johan-954/Projet_1DA/Commande/DigiKey/2026-05-20T041745.xlsx

DigiKey - Panier
Index | Quantité | Référence | Référence fabricant | Description | Référence client | Disponible | Articles différés | Prix unitaire | Prix calculé EUR
1 | 2 | 5272-AMS1117-5.0CT-ND | AMS1117-5.0 | IC REG LINEAR 5V 1A SOT-223-3L |  | 2 | 0 | 0.25 | 0.50
2 | 1 | 1778-COM3700-ND | COM3700 | MINI SUBMERSIBLE WATER PUMP |  | 1 | 0 | 3.14 | 3.14
