johan-954/Projet_1DA/KiCad/Utilities/1294/1294.step

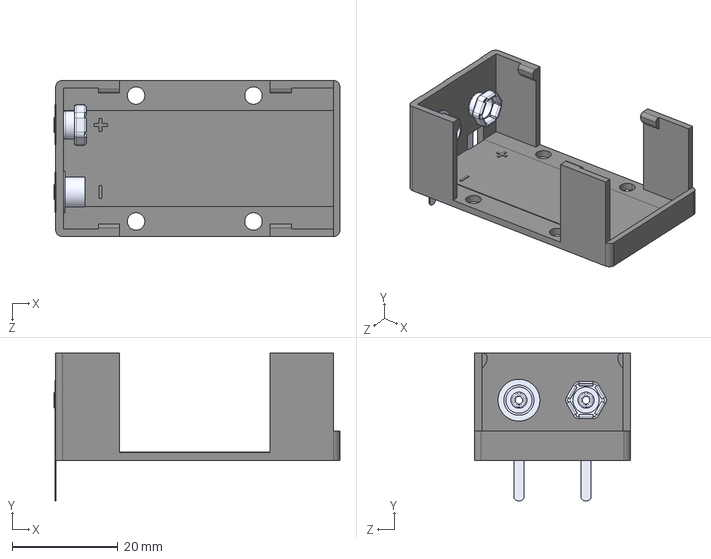
[picture p7: CAD file, 2026-05-06]
KiCad/Utilities/1294/1294.step
54.2 x 27.9 x 29.6 mm
