johan-954/Projet_1DA/KiCad/Utilities/BC547C/BC547C.step

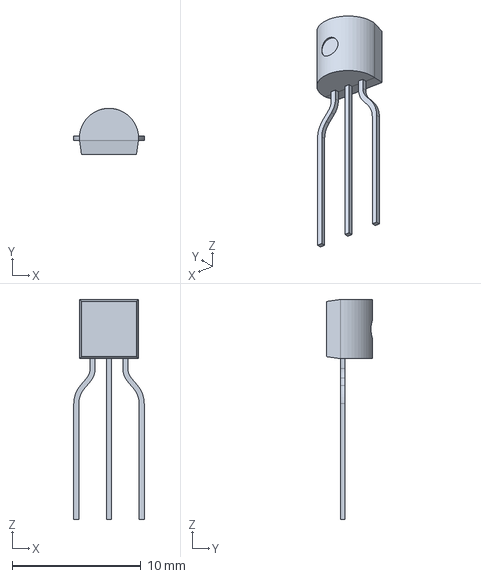
[picture p8: CAD file, 2026-05-04]
KiCad/Utilities/BC547C/BC547C.step
5.48 x 3.60 x 17.1 mm
