johan-954/Projet_1DA/KiCad/Utilities/ESP32-C3_SUPERMINI_TH/ESP32-C3_SUPERMINI_TH.step

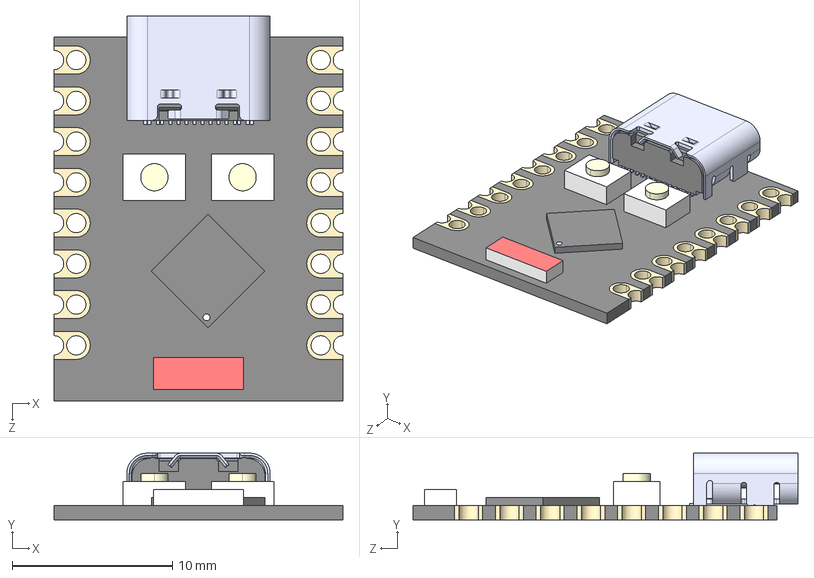
[picture p9: CAD file, 2026-05-04]
KiCad/Utilities/ESP32-C3_SUPERMINI_TH/ESP32-C3_SUPERMINI_TH.step
18.0 x 4.16 x 24.0 mm
Board c3mini
USB C
components (other)^ESP32-C3 SuperMini
