johan-954/Projet_1DA/KiCad/Utilities/MCP6022-I_ST/MCP6022-I_ST.step

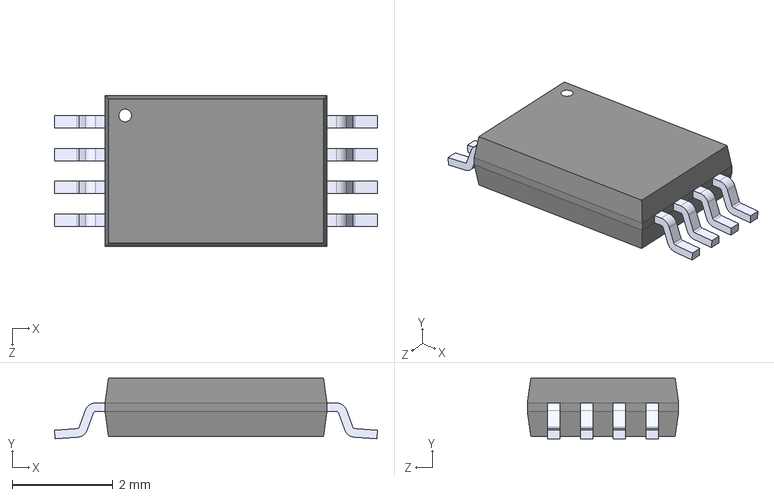
[picture p10: CAD file, 2026-05-04]
KiCad/Utilities/MCP6022-I_ST/MCP6022-I_ST.step
6.40 x 1.20 x 3.00 mm
