johan-954/Projet_1DA/IUT/Dossier de fabrication de la carte luminosité LOUVET - KARAMA.docx

Dossier de fabrication DE LA CARTE Capteur de luminositE

SAE s2

TD3/TP6

Antonin LOUVET & Mohammed-Amine KARAMA

VI. Liste des composants avec leurs références et une estimation du prix19

VIII. Conclusion20

I. Sommaire des figures :

Figure 1 : Diagramme de la bête à corne4

Figure 2 : Schéma électronique de la carte capteur de luminosité5

Figure 3 : Schéma Proteus de la fonction FS1, connecteur 9 broches mâle6

Figure 4 : Schéma de la fonction FS2, détection de la carte7

Figure 5 : Schéma simplifié D3 de la fonction FS2, détection de la carte8

Figure 6 : Schéma simplifié D2 de la fonction FS2, détection de la carte et schéma équivalent 9

Figure 7 : Schéma Proteus de la fonction FS3, polarisation de la diode10

Figure 8 : Graphique du courant Ip et de la tension V0 en fonction de la luminosité Ev11

Figure 9 : Schéma Proteus de la fonction FS4, montage suiveur12

Figure 10 : Schéma Proteus de la fonction FS5, filtrage13

Figure 11 : Schéma Proteus simplifié de la fonction FS5, filtrage13

Figure 12 : Vue du dessous du circuit (typon)16

Figure 13 : Vue 3D (recto) du circuit (qui fera office de plan de montage)18

Figure 14 : Schéma de principe de l’utilisation de la carte capteur de luminosité20

II. Introduction :

Ce projet de SAE consiste à commercialiser une station de mesure “low-cost”.

On fabrique 3 cartes qui doivent mesurer :

- la température ambiante, en degré Celsius ou Fahrenheit ;
- la luminosité ambiante, en Lux ;
- la distance qui sépare le véhicule d’un objet, en mètre.

Ce produit est destiné aux conducteurs de voitures qui auront besoin :

- de connaître la température ambiante à l’intérieur et à l’extérieur du véhicule ;

- de mesurer la luminosité ambiante à l’intérieur et à l’extérieur du véhicule et en fonction du résultat, changer l’apparence du GPS ;

- d’évaluer la distance qui sépare le véhicule de l’environnement lors d’une manœuvre.

Expression du besoin

Figure 1 : Diagramme de la bête à corne

Les conducteurs

Station de Mesure

Mesurer et afficher des grandeurs physiques liées à un véhicule : température, luminosité et distance

Environnement intérieur/extérieur et proche du véhicule

Dans cette deuxième partie, il va s’agir d’étudier le capteur de luminosité.

Pour obtenir la valeur de la luminosité ambiante, il faut utiliser une photodiode dont la tension aux bornes varie en fonction du courant et de la luminosité.

Pour la réalisation de cette deuxième carte, le schéma électronique de la carte capteur de luminosité présentera plusieurs fonctions :

- FS1 : Connecteur 9 broches avec les différentes entrées et sorties ;

- FS2 : Détection de la carte ;

- FS3 : Polarisation de la photodiode ;

- FS4 : Montage suiveur ;

- FS5 : Filtrage.

Figure 2 : Schéma électronique de la carte capteur de luminosité


Pour l’étude du schéma électronique de la carte capteur de luminosité, on cherche à déterminer les composants dont on ne connaît pas encore les valeurs ainsi que l’utilité de chacune des fonctions.

Il faut commencer par étudier la fonction FS1 :

Pour que la carte puisse être reliée à la carte micro (station de mesure), il faut qu’elle possède un connecteur 9 broches ; ce connecteur permet de faire passer des tensions et des courants d’entrée et de sortie entre la carte et la station de mesure.

Figure 3 : Schéma Proteus de la fonction FS1, connecteur 9 broches mâle

Puis il faut étudier la fonction FS2 :

- Pour la détection d’un tel capteur par le microcontrôleur, on utilise deux entrées numériques P0 et P1 pour déterminer la résistance R1 afin que VD3 > 3V.

Figure 4 : Schéma de la fonction FS2, détection de la carte

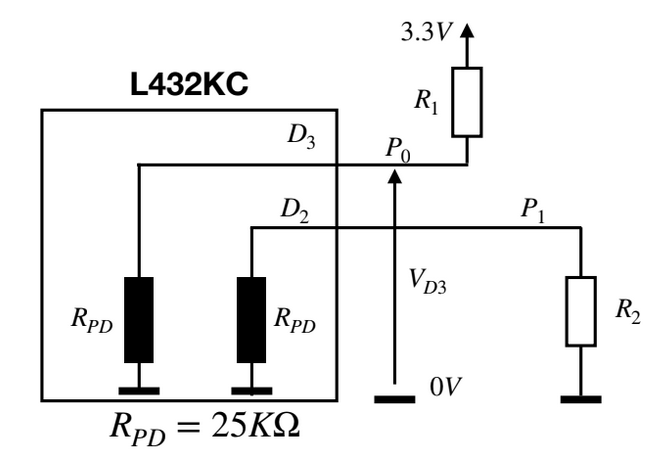
[picture p11: figure]

On simplifie le schéma D3 de la fonction FS2, détection de la carte.

Figure 5 : Schéma simplifié D3 de la fonction FS2, détection de la carte

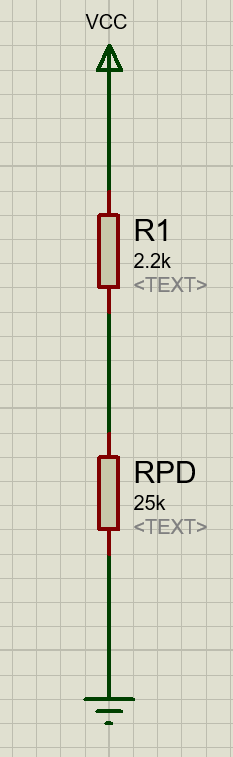
[picture p12: figure]

Vd3 ⩾ 3 V

Ve = 3,3 V

On étudie le schéma simplifié de la fonction FS2, détection de la carte :

D’après le théorème du pont diviseur, on a VD3 = (R_(PD))/(R_(PD) +R_1) *V_e

On cherche VD3 = (R_(PD))/(R_(PD) +R_1) *V_e ≥ V_(seuil) avec V_(seuil) = 3 V

Donc R_(PD) *V_e ≥ V_(seuil) * ( R_(PD) +R_1 ) ⇔ (R_(PD) * V_e)/(V_(seuil)) ≥ ( R_(PD) +R_1 ) ⇔ (R_(PD) * V_e)/(V_(seuil)) - R_(PD) ≥ R_1

Application numérique : R_1 ≤ (25000 * 3,3)/3 – 25000 donc R_1 ≤ 2500 Ω

Comme il n’y a pas de résistance de 2,5 kΩ, on utilise une résistance normalisée de 2,2 kΩ pour R_1 , celle-ci correspond à la valeur la plus proche de celle calculée.

- On cherche également à déterminer la résistance R2 afin que la résistance équivalente sur D2 soit de 20KΩ.

On simplifie la deuxième partie D2 du schéma de la fonction FS2, détection de la carte, afin de déterminer la valeur de la résistance R2.

Figure 6 : Schéma simplifié D2 de la fonction FS2, détection de la carte et schéma équivalent

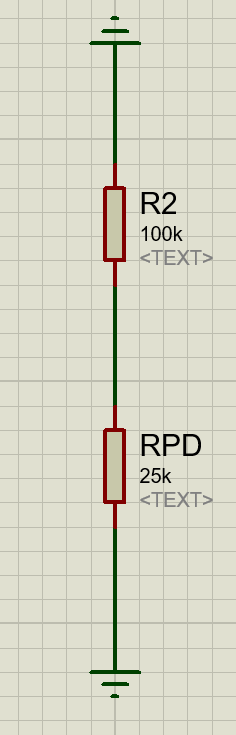
[picture p13: figure]
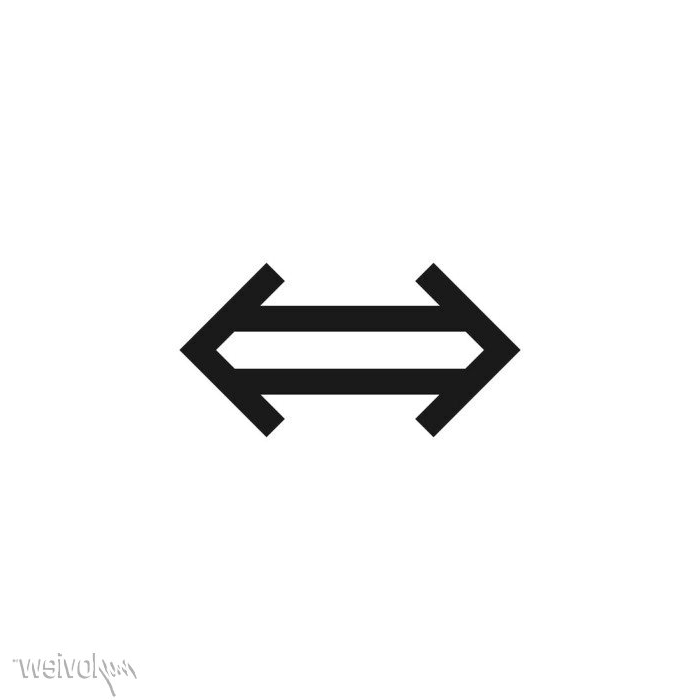
[picture p14: figure]
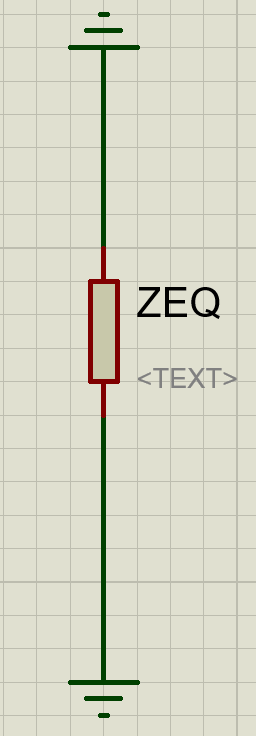
[picture p15: figure]

On étudie le schéma simplifié D2 de la fonction FS2, détection de la carte et son schéma équivalent :

Zeq = (R_2 * R_(PD))/(R_2 + R_(PD)) comme Zeq = 20000 Ω ⇔ (R_2 * R_(PD))/(R_2 + R_(PD)) = 20000 ⇔ R_2 * R_(PD) = 20000 * ( R_2 + R_(PD) )

⇔ R_2 * R_(PD) = 20000 * R_2 + 20000*R_(PD) ⇔ R_2 = 20000 * (R_2)/(R_(PD)) + 20000

⇔ R_2 = R_2 * 20000/25000 + 20000 ⇔ R_2 = R_2 * 20000/25000 + 20000 ⇔ R_2 = R_2 * 0,8 + 20000

⇔ R_2 - R_2 * 0,8 = 20000 ⇔ R_2 * 0,2 = 20000 ⇔ R_2 = 20000/(0,2) ⇔ R_2 = 100 kΩ

On prend donc une résistance R2 de 100 kΩ.

Puis il faut étudier la fonction FS3 :

Celle-ci permet de polariser la diode et de choisir le point de fonctionnement.

Figure 7 : Schéma Proteus de la fonction FS3, polarisation de la diode

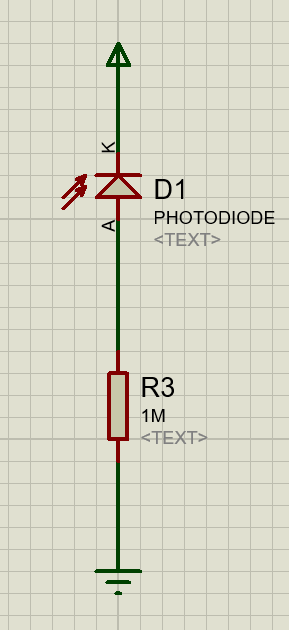
[picture p16: figure]

Ve = 3,3 V

Ip = 1 µA

Vm

On cherche à déterminer le courant inverse dans la photodiode pour un éclairement Ev = 100 lux ; on étudie donc le graphique ci-dessous, indiquant le courant Ip ( en µA ) et la tension V0 ( en mV ) en fonction de la luminosité Ev ( en lux ).

Figure 8 : Graphique du courant Ip et de la tension V0 en fonction de la luminosité Ev

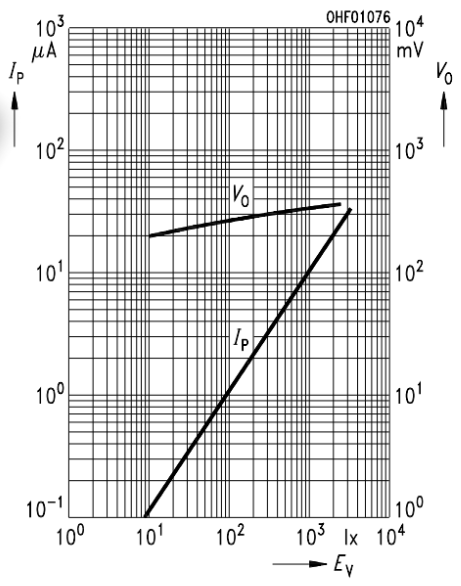
[picture p17: figure]

D’après le graphique du courant Ip et de la tension V0 en fonction de la luminosité Ev, pour EV = 100 lux on a Ip = 1 µA.

On cherche ensuite à estimer la tension aux bornes de R3 = 1 MΩ.

On étudie le schéma Proteus de la fonction FS3, polarisation de la diode.

D’après la Loi d’Ohm : Vm = R3 * IP

Donc Vm = 1*10⁶ *1*10⁻⁶ ⇒ Vm = 1 V

On a donc une tension Vm de 1 V.

Ensuite, on étudie la fonction FS4.

Figure 9 : Schéma Proteus de la fonction FS4, montage suiveur

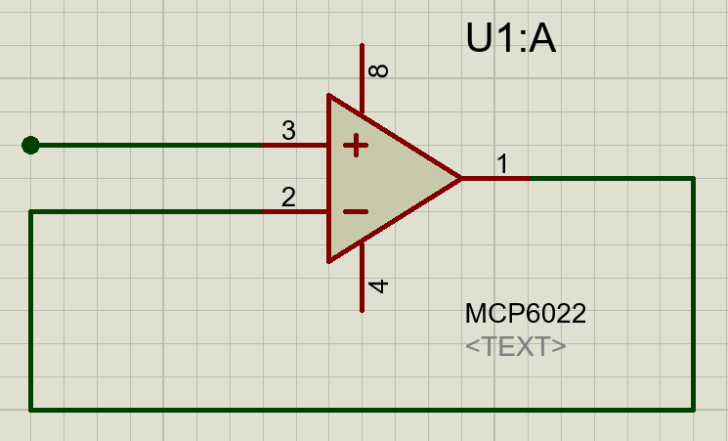
[picture p18: figure]

Vm

V

La fonction FS4, du montage suiveur, permet de :

- copier la tension d’entrée V sur la tension de sortie Vm ;

- isoler les différentes parties du circuit.

Pour finir, on étudie la fonction FS5 :

La fonction FS5 permet de filtrer les parasites lorsque la fréquence est supérieure à 10 Hz.

Des parasites apparaissent lorsque nous branchons ou débranchons la carte.

Figure 10 : Schéma Proteus de la fonction FS5, filtrage

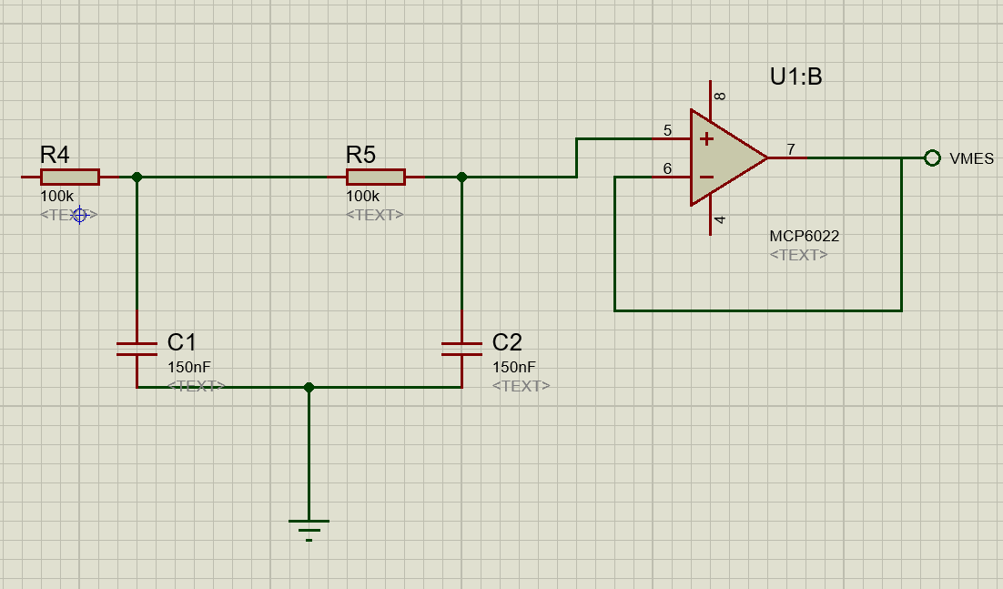
[picture p19: figure]

Vmes

Vm

On cherche à déterminer les valeurs de R4, R5, C1 et C2.

On simplifie alors le schéma Proteus de la fonction FS5, filtrage, en utilisant le théorème de Thévenin :

Figure 11 : Schéma Proteus simplifié de la fonction FS5, filtrage

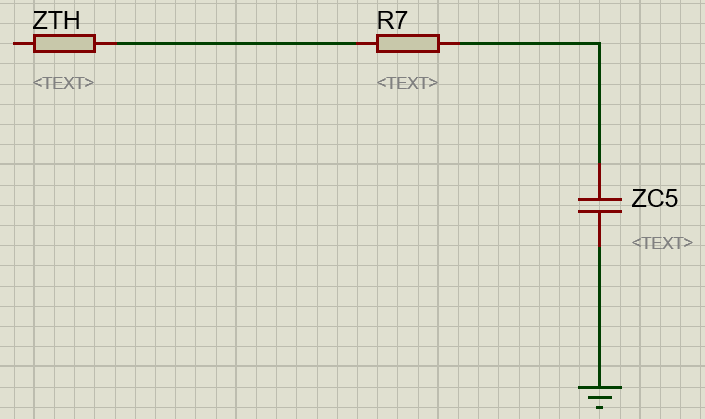
[picture p20: figure]

Vmes

eTH

On calcule la fonction de transfert du filtre du second ordre (v_(mes))/(v_m) (jw):

D’après le schéma Proteus simplifié de la fonction FS5, filtrage, on a :

Zth = (R_4 * 1/(JC1W))/(R_4 + 1/(JC1W)) ⇔ Zth = (R_4)/(JR_4 C1W + 1)

Et Eth = (1/(JC1W))/(R_4 + 1/(JC1W)) * Vm ⇔ Eth = 1/(JR_4 C1W + 1) * Vm

D’après le théorème du pont diviseur :

Vmes = (1/(JC2W))/(R_5 + 1/(JC2W) + Zth) * Eth ⇔ Vmes = 1/(1 + JR_5 C2W + (JR_4 C2W)/(1+JR_4 C1W)) * Eth

⇔ Vmes = 1/(1 + JR_5 C2W + (JR_4 C2W)/(1+JR_4 C1W)) * 1/(JR_4 C1W + 1) * Vm

⇔ Vmes = 1/(JR_4 C1W + 1 + JR_5 C2W + ( JR_5 C2W ) * ( JR_4 C1W ) + JR_4 C2W) * Vm

⇔ (Vmes)/(Vm) = 1/(1 + JW ( R_4 C1 + R_5 C2 + R_4 C2 )+ (JW)^2 * ( R_5 R_4 C2C1 ))

On sait que (Vmes)/(Vm) = 1/(1 + J W/(W0) 2m + (JW/(W0))^2) (forme canonique du second ordre)

Par identification :

1/(W_0^2) = R_5 R_4 C2C1 ⇔ W_0^2 = 1/(R_5 R_4 C2C1) ⇔ W_0^() = 1/(√(R_5 R_4 C2C1))

et (2m)/(W_0^()) = ( R_4 C1 + R_5 C2 + R_4 C2 ) ⇔ 2m = W_0^() ( R_4 C1 + R_5 C2 + R_4 C2 )

⇔ m = 1/2 (( R_4 C1 + R_5 C2 + R_4 C2 ))/(√(R_5 R_4 C2C1))

Si C1 = C2 = C et R4 = R5 = R

Alors (Vmes)/(Vm) = 1/(1 + 3JRCW + (JRCW)^2)

Par identification :

W0 = 1/(RC) or W0 = 2π*f0 donc 1/(RC) = 2π*f0 ⇔ RC = 1/(2π*fo)

On cherche à déterminer R4, R5, C1 et C2 pour obtenir une fréquence propre f0 = 10 Hz :

Sachant que RC = 1/(2π*fo) ⇔ RC = 1/(2π*10) ⇔ RC = 15,9 * 10⁻³

On prend R = 100 kΩ

Donc C = (15,9 * 10^(-3))/(100 * 10^3) ⇔ C = 1,59 * 10⁻⁷ F = 159 nF

Donc R4 = R5 = 100 kΩ et C1 = C2 = 159 nF

Comme il n’y a pas de condensateur de 159 nF, on utilise deux condensateurs normalisés 150 nF pour C1 et C2, ce qui correspond à la valeur la plus proche de celle calculée.

Figure 12 : Vue de dessous du circuit (typon)

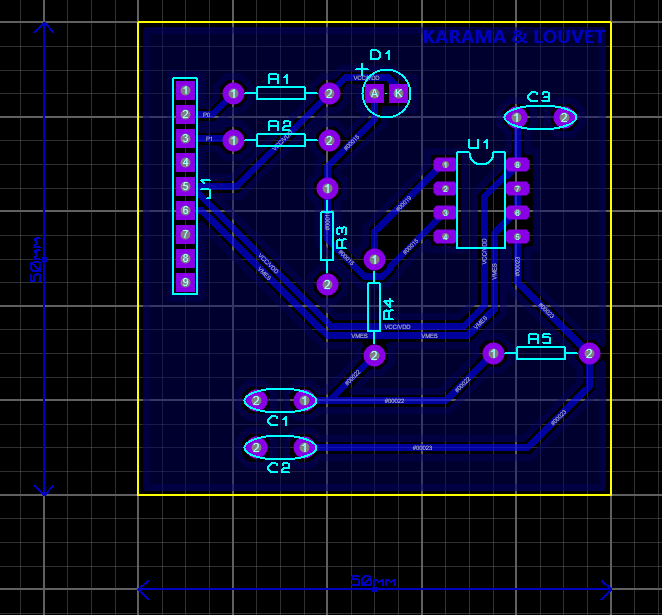
[picture p21: figure]

Pour réaliser le dossier typon, on doit respecter le cahier des charges de la carte luminosité, à savoir :

- un tel capteur sera alimenté en mono tension [0 ; 3.3V] ;
- après une calibration, le capteur fournira en sortie une tension image de la luminosité ambiante ;
- le capteur sera capable de mesurer une luminosité de 0 à 4000 lux ;
- la liaison, entre le capteur et la carte microcontrôleur, sera réalisée via un connecteur 9 broches mâle ;
- pour mesurer la luminosité ambiante, on utilise une photodiode ; en effet il apparait un courant inverse Ip, dont l’intensité est fonction de l’éclairement reçu.

Figures 13 : Vue 3D (recto) du circuit (qui fera office de plan de montage)

VI. Liste des composants avec leurs références et une estimation du prix :

Composants | Valeurs | Références radiospare | Prix
R1 | 2,2kΩ | CFR1-4W-2K2 | 0.17€/Pcs
R2 | 100kΩ | 707-7824 | 0,123 €/Pcs
R3 | 1MΩ | 707-7903 | 0,164 €/Pcs
R4 | 100kΩ | 707-7824 | 0,123 €/Pcs
R5 | 100kΩ | 707-7824 | 0,123 €/Pcs
C1 | 150nF | B32671P6154K000 | 0,64 €/Pcs
C2 | 150nF | B32671P6154K000 | 0,64 €/Pcs
C3 | 470nF | B32672Z4474K000 | 0,53 €/Pcs
D1 | | 1N914 | 0,093 €/Pcs
AOP | | MCP6022 | 1,73 €/Pcs
Connecteur 9 broches | 40 broches | 9-146282-0 | 3,54€/Pcs

Lorsque l’on additionne tous les composants, on obtient :

0,17 + 0,123 + 0,164 + 0,123 + 0,123 + 0,64 + 0,64 + 0,53 + 0,093 + 1,73+ 3,54 = 7,876

Donc le coût de la carte sera de 7,876 €.

VII. Notice d’utilisation :

Cette carte de mesure de la luminosité ambiante sera branchée sur une carte MICRO à l’aide du connecteur 9-broches.

La carte MICRO fonctionne avec un microcontrôleur STM32 Nucleo L432KC et sera reliée à un PC par voie filaire qui possède l’IHM.

Ainsi on obtiendra le Schéma de principe de l’utilisation de la carte capteur de luminosité :

Figure 14 : Schéma de principe de l’utilisation de la carte capteur de luminosité :

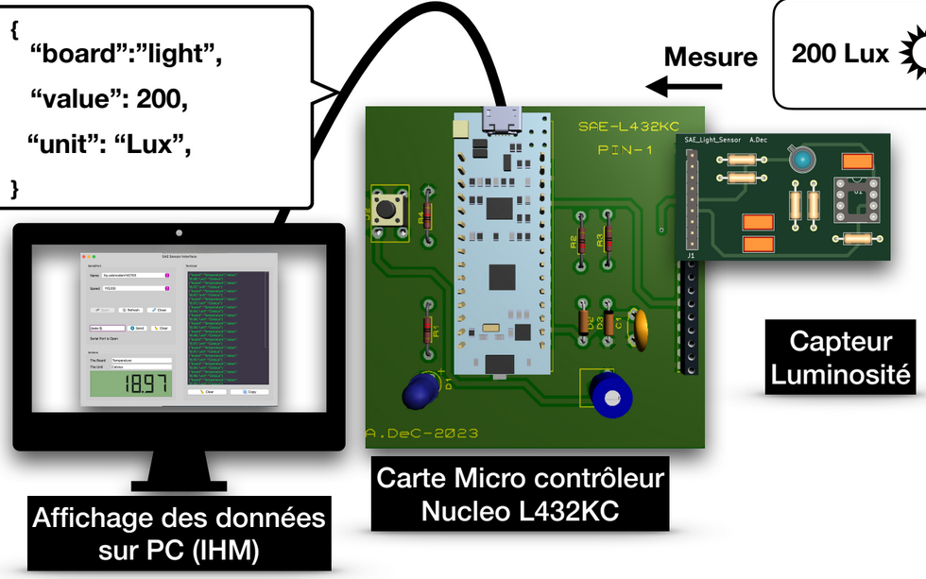
[picture p22: figure]

La carte de mesure est composée d’un capteur à base de photodiode, alimenté en mono tension [0 ; 3.3V]. Après calibration, ce capteur fournira en sortie une tension image de la luminosité ambiante en lux. Cette tension sera envoyée grâce à la carte MICRO vers le PC (IHM) qui affichera donc la luminosité ambiante.

VIII. Conclusion :

Pour conclure, on a choisi les composants qui correspondent aux calculs théoriques. Ceux qui ne correspondent pas aux valeurs théoriques trouvées sont ceux qui sont indisponibles. Par exemple, en l’absence de condensateur de 159 nF, on prend un condensateur de 150 nF. Cependant, le fait de changer la valeur de certains composants n’a pas d’impact sur le bon fonctionnement de la carte.

Il reste donc à réaliser la soudure de la carte, puis procéder à des tests de vérification de son bon fonctionnement et terminer par la programmation.

Dossier de fabrication BUT 1 – SAE S2
