johan-954/Projet_1DA/LTspice/Temperature/Temperature.asc

C1: cap; 100n
C2: cap; 100n
D1: diode
Q1: npn
Q2: npn
R1: res; 33k
R2: res; 10k
R3: res; 10k
R4: res; 10k
R5: res; 10k
R6: res; 10k
R7: res; 2.2k
R8: res; 5.1k
R9: res; 10k
U1: UniversalOpAmp2
U2: UniversalOpAmp2
V1: voltage; 2.5V
V2: voltage; 3.3V
Named nets: 0, +3.3V, +VCom
.tran 0 100m 0 0.01m
.step temp 0 100 25
