johan-954/Projet_1DA/LTspice/Luminosite/Luminosite_-Vdd_Vdd.asc

C1: cap; 100n
C2: cap; 220n
C3: cap; 10p
I1: current; SINE(0 50u 100)
R1: res; 10k
R2: res; 10k
R3: res; 100k
R4: res; 68k
R5: res; 10k
R6: res; 10k
U3: UniversalOpAmp2
U4: UniversalOpAmp2
V1: signal; AC 1 0
V2: voltage; -3.3V
V3: voltage; +3.3V
Named nets: 0, +3.3V, -3.3V
.ac dec 500 1 10k
Sallen Key
.tran 0 100m 0 0.1m
Transformation A/V
Pas necessaire, a voir quand TP
