johan-954/Projet_1DA/KiCad/Luminosite/Luminosite.kicad_pcb

## KiCad design KiCad/Luminosite/Luminosite.kicad_pcb (2026-05-20)

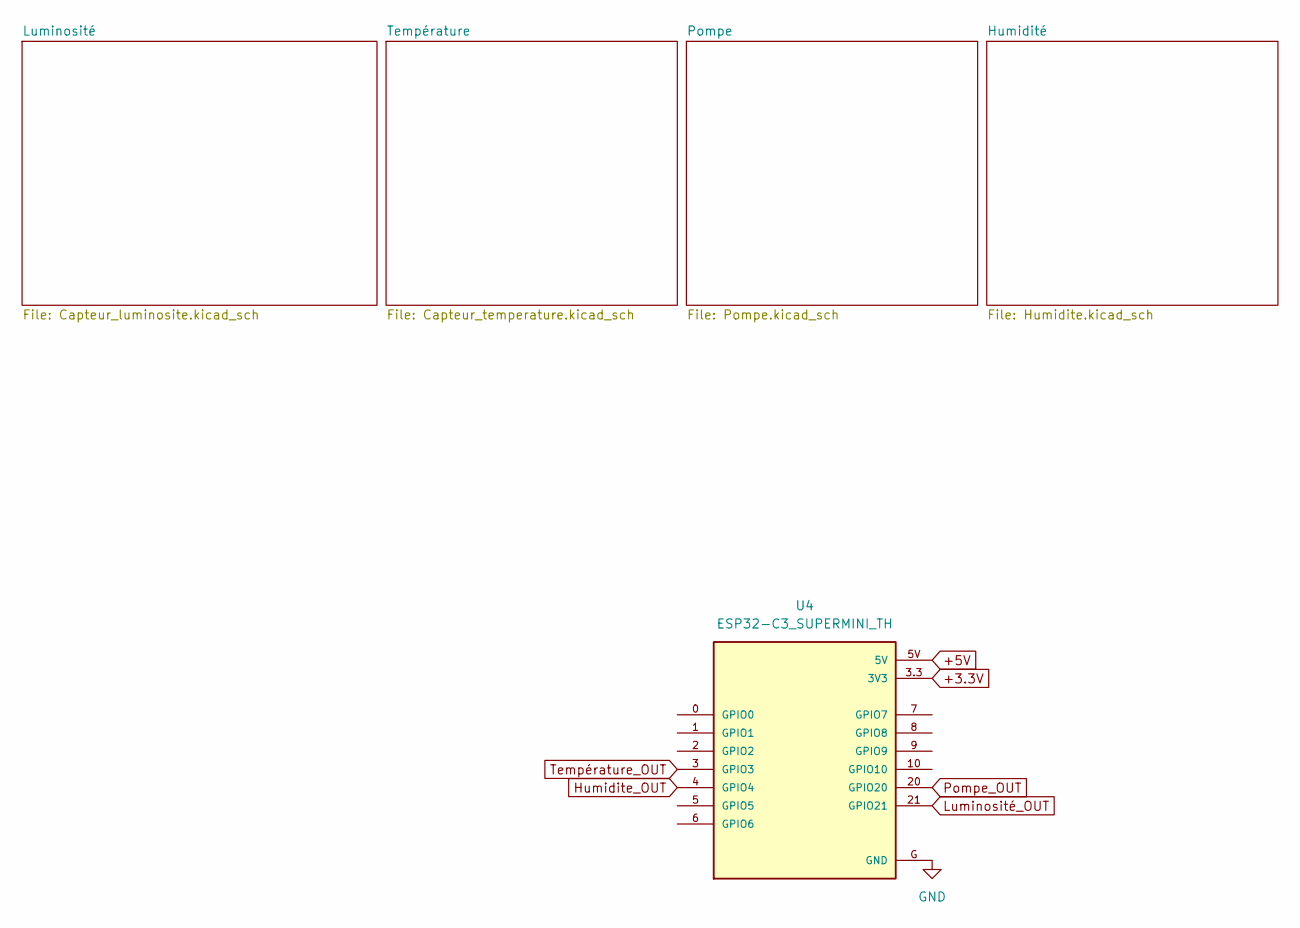
[picture p23: schematic Luminosite.kicad_sch]

Parts:
U4: ESP32-C3_SUPERMINI_TH; MODULE_ESP32-C3_SUPERMINI_TH

Connections:
+3.3V: U4.3.3 (3V3); also elsewhere on the board
+5V: U4.5V; also elsewhere on the board
GND: U4.G (GND); also elsewhere on the board
Humidite_OUT: U4.4 (GPIO4); also elsewhere on the board
Luminosité_OUT: U4.21 (GPIO21); also elsewhere on the board
Pompe_OUT: U4.20 (GPIO20); also elsewhere on the board
Température_OUT: U4.3 (GPIO3); also elsewhere on the board

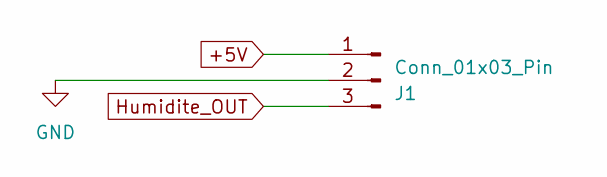
[picture p24: schematic Humidite.kicad_sch]

Parts:
J1: Conn_01x03_Pin; PinHeader_1x03_P2.54mm_Horizontal

Connections:
+5V: J1.1; also elsewhere on the board
GND: J1.2; also elsewhere on the board
Humidite_OUT: J1.3; also elsewhere on the board

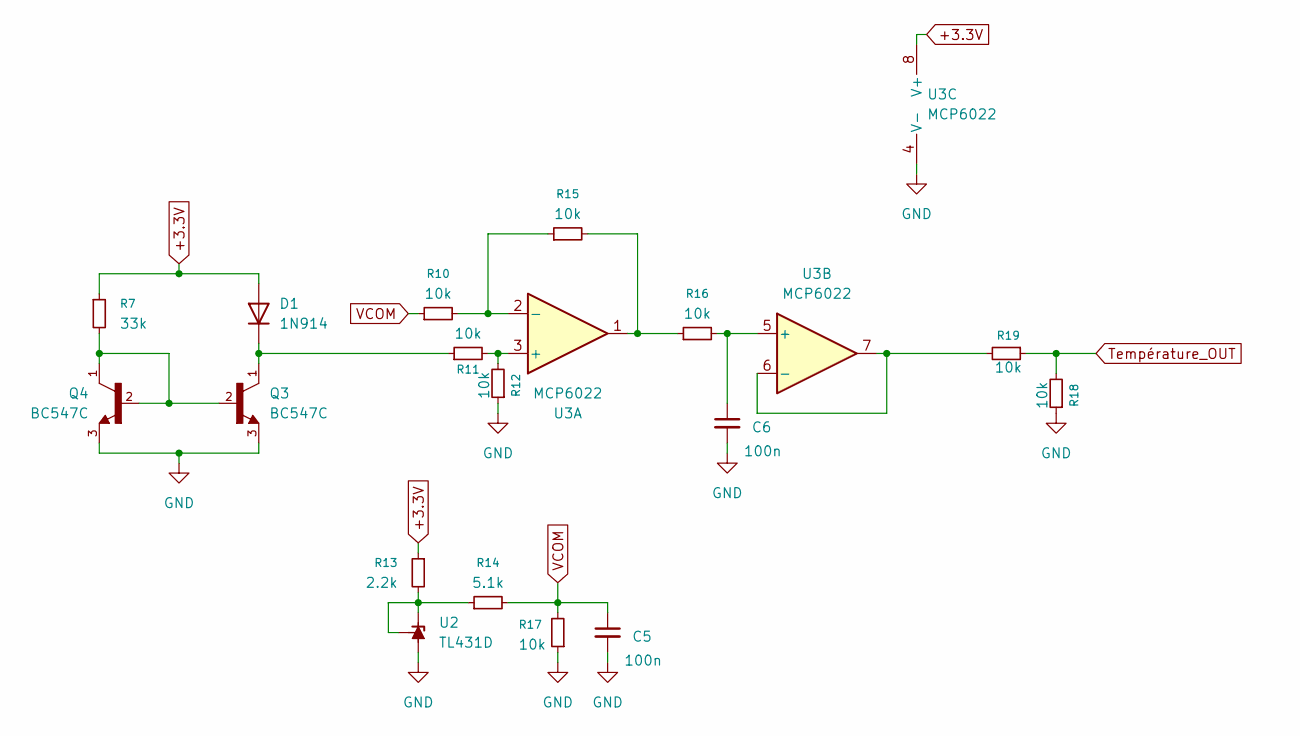
[picture p25: schematic Capteur_temperature.kicad_sch]

Parts:
C5, C6: 100n; C_0603_1608Metric_Pad1.08x0.95mm_HandSolder
D1: 1N914; D_DO-35_SOD27_P7.62mm_Horizontal
Q3, Q4: BC547C; TRANS_BC547C; PARTREV 2022-11-28
R7: 33k; R_0603_1608Metric_Pad0.98x0.95mm_HandSolder
R10, R11, R12, R15, R16, R17, R18, R19: 10k; R_0603_1608Metric_Pad0.98x0.95mm_HandSolder
R13: 2.2k; R_0603_1608Metric_Pad0.98x0.95mm_HandSolder
R14: 5.1k; R_0603_1608Metric_Pad0.98x0.95mm_HandSolder
U2: TL431D; SOIC-8_3.9x4.9mm_P1.27mm
U3: MCP6022; SOP8P65_300X640X120L60X24N

Connections:
+3.3V: D1.2 (A), R7.1, R13.1, U3.8 (V+); also elsewhere on the board
GND: C5.2, C6.2, Q3.3, Q4.3, R12.1, R17.1, R18.1, U2.2 (A), U2.3 (A), U2.6 (A), U2.7 (A), U3.4 (V-); also elsewhere on the board
unnamed: D1.1 (K), Q3.1, R11.1
unnamed: Q3.2, Q4.1, Q4.2, R7.2
unnamed: R15.2, R16.1, U3.1
unnamed: R13.2, R14.1, U2.1 (K), U2.8 (REF)
unnamed: R11.2, R12.2, U3.3 (+)
unnamed: R10.2, R15.1, U3.2 (-)
unnamed: C6.1, R16.2, U3.5 (+)
unnamed: R19.2, U3.6 (-), U3.7
Température_OUT: R18.2, R19.1; also elsewhere on the board
VCOM: C5.1, R10.1, R14.2, R17.2

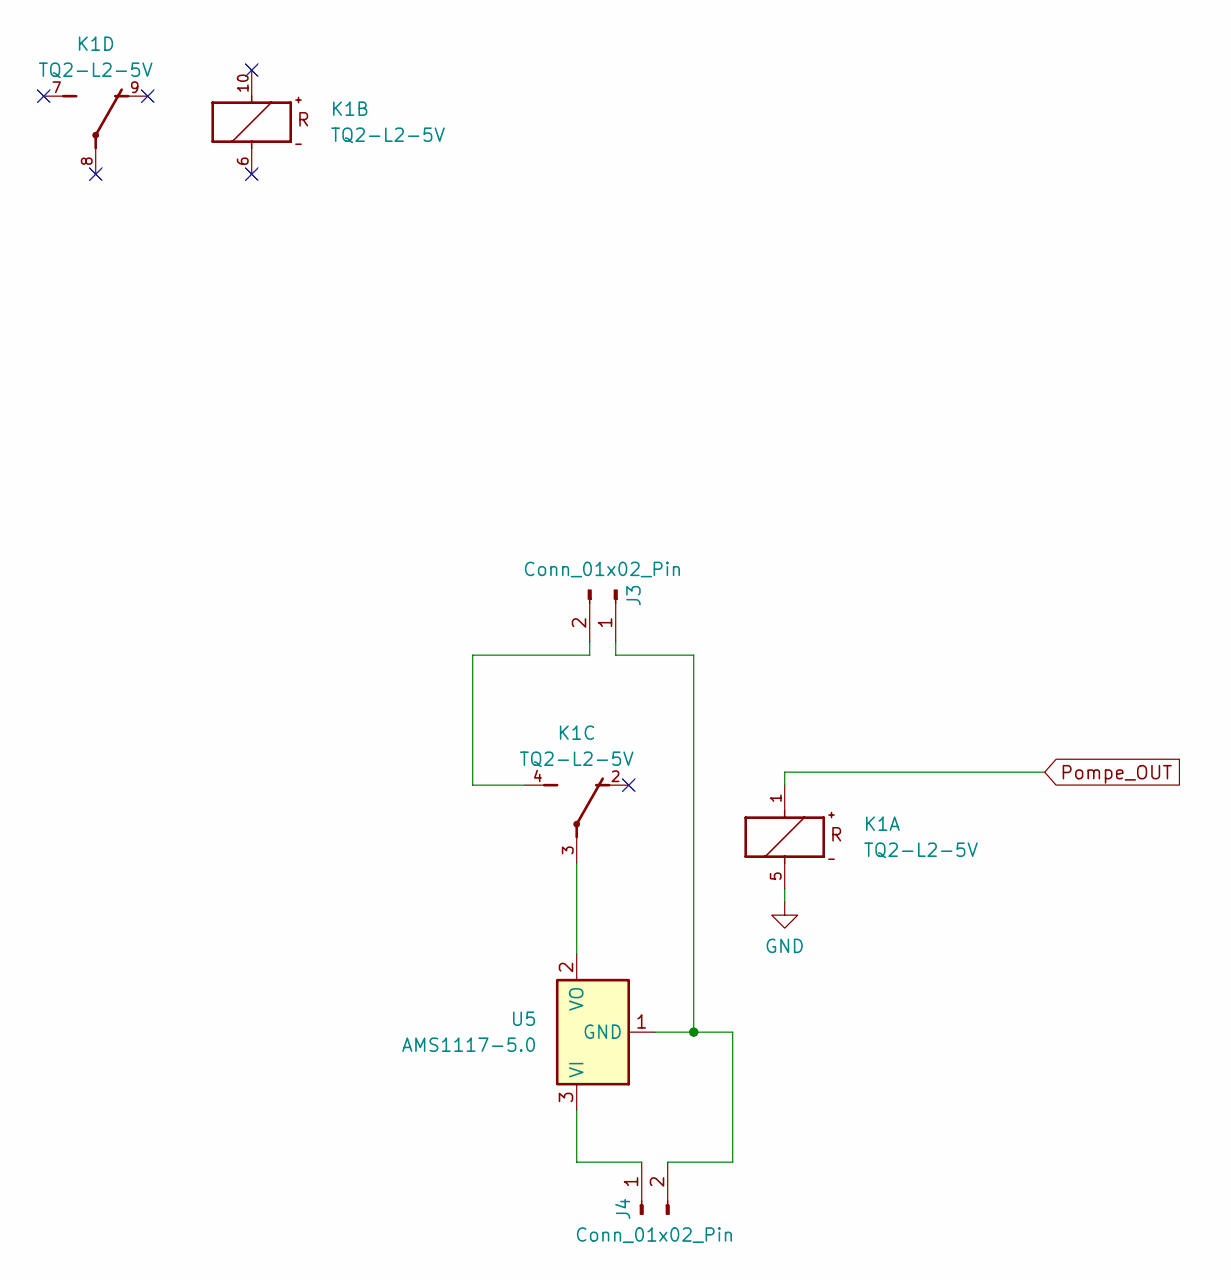
[picture p26: schematic Pompe.kicad_sch]

Parts:
J3, J4: Conn_01x02_Pin; PinHeader_1x02_P2.54mm_Horizontal
K1: TQ2-L2-5V; TQ2; FARNELL 1175718
U5: AMS1117-5.0; SOT-223-3_TabPin2

Connections:
GND: K1.5; also elsewhere on the board
unnamed: J3.1, J4.2, U5.1 (GND)
unnamed: J3.2, K1.4
unnamed: J4.1, U5.3 (VI)
unnamed: K1.3, U5.2 (VO)
Pompe_OUT: K1.1; also elsewhere on the board

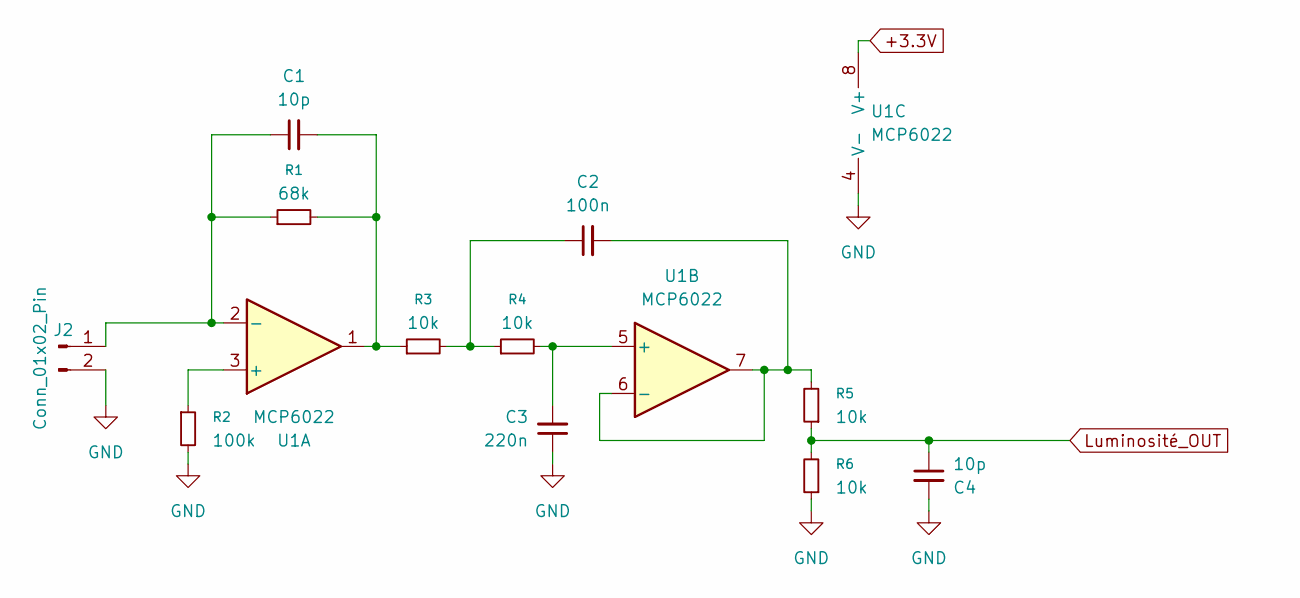
[picture p27: schematic Capteur_luminosite.kicad_sch]

Parts:
C1, C4: 10p; C_0603_1608Metric_Pad1.08x0.95mm_HandSolder
C2: 100n; C_0603_1608Metric_Pad1.08x0.95mm_HandSolder
C3: 220n; C_0603_1608Metric_Pad1.08x0.95mm_HandSolder
J2: Conn_01x02_Pin; PinHeader_1x02_P2.54mm_Horizontal
R1: 68k; R_0603_1608Metric_Pad0.98x0.95mm_HandSolder
R2: 100k; R_0603_1608Metric_Pad0.98x0.95mm_HandSolder
R3, R4, R5, R6: 10k; R_0603_1608Metric_Pad0.98x0.95mm_HandSolder
U1: MCP6022; SOP8P65_300X640X120L60X24N

Connections:
+3.3V: U1.8 (V+); also elsewhere on the board
GND: C3.1, C4.2, J2.2, R2.2, R6.1, U1.4 (V-); also elsewhere on the board
Luminosité_OUT: C4.1, R5.1, R6.2; also elsewhere on the board
unnamed: C1.2, R1.2, R3.1, U1.1
unnamed: C2.1, R3.2, R4.1
unnamed: C1.1, J2.1, R1.1, U1.2 (-)
unnamed: R2.1, U1.3 (+)
unnamed: C3.2, R4.2, U1.5 (+)
unnamed: C2.2, R5.2, U1.6 (-), U1.7

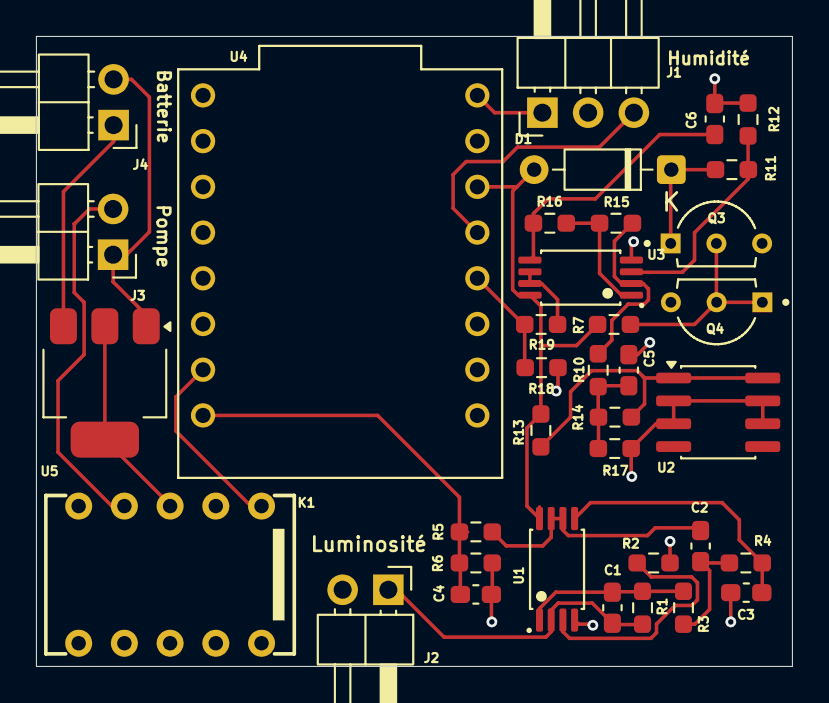
[picture p28: board Luminosite.kicad_pcb from above]

Board: 2 copper layers, 42.0 x 35.0 mm, 36 parts (0 on the bottom side), 26 nets.
