johan-954/Projet_1DA/(commit log)

2026-04-19 Création du projet et ajout des anciens fichiers
2026-04-19 Schéma Kicad luminosité
    [Luminosite.kicad_pcb, Luminosite.kicad_sch]
2026-04-19 Ajout des fichiers LTspice
2026-04-19 Nommage des fichiers LTspice
2026-04-20 Capteur de température
    [Capteur_luminosite.kicad_sch, Capteur_temperature.kicad_sch, Luminosite.kicad_sch]
2026-04-20 Schéma LTspice temperature
2026-05-04 Ajout des empreintes pour le PCB
    [Capteur_temperature.kicad_sch, Luminosite.kicad_pcb, Luminosite.kicad_sch, MCP6022-I_ST.step, Pompe.kicad_sch]
2026-05-04 Ajout du Schéma Pompe
    [Capteur_temperature.kicad_sch, Luminosite.kicad_sch, Pompe.kicad_sch]
2026-05-04 Commencement du PCB
    [BC547C.step, Capteur_luminosite.kicad_sch, Capteur_temperature.kicad_sch, Luminosite.kicad_pcb, Luminosite.kicad_sch, Pompe.kicad_sch]
2026-05-05 Modification du PCB
    [Humidite.kicad_sch, Luminosite.kicad_pcb, Luminosite.kicad_sch, Pompe.kicad_sch]
2026-05-05 PCB Terminé
    [Luminosite.kicad_pcb, Luminosite.kicad_sch, Pompe.kicad_sch]
2026-05-06 Doc Commande
    [1294.step, Capteur_luminosite.kicad_sch, Commande_DigiKey.xlsx, Commande_Farnell.xlsx, Commande_RS.xlsx, Composants.xlsx, Luminosite.kicad_pcb, commande.xlsx]
2026-05-06 Finalisation PCB
    [Luminosite.kicad_pcb]
